NHLStenden-CVDS/TwirreShield/partlist_PCB.xlsx

PARTLIST
R1 | 10K | 0805
R2 | 1K
R3 | 10K
R4 | 10K
R5 | 100
R6 | 100
R7 | 100
R8 | 10k
R9 | 10k
R10 | 10k
R11 | 10k
R12 | 100k
R13 | 15k
R14 | 100k
R15 | 15k
R16 | 100k
R17 | 15k
R18 | 100k
R19 | 15k
R20 | 100
R21 | 100
R22 | 220
Type | Value | Package | Count
Resistor | 100K | 0805 | 4
Resistor | 15K | 0805 | 4
Resistor | 10K | 0805 | 7
Resistor | 1K | 0805 | 1
Resistor | 220 | 0805 | 1
Resistor | 100 | 0805 | 5
LED | RED | 0805 | 2 | http://nl.farnell.com/osram/lsr976/led-0805-red-50mcd-632nm/dp/1226392
LED | GREEN | 0805 | 1 | http://nl.farnell.com/kingbright/kp-2012cgck/led-0805-50mcd-green/dp/2290331
LED | RGB | 5MM | 1 | http://nl.farnell.com/kingbright/l-154a4surkqbdzgw/led-multi-colour-rgb-5mm/dp/2290374
Connector | 6-pin | JST-XH | 1 | http://nl.farnell.com/jst-japan-solderless-terminals/b6b-xh-a-lf-sn/connector-header-tht-2-5mm-6way/dp/1516282
Connector | 5-pin | JST-XH | 3 | http://nl.farnell.com/jst-japan-solderless-terminals/b5b-xh-a-lf-sn/header-tht-vertical-2-5mm-5way/dp/1516281
Connector | 4-pin | JST-XH | 10 | http://nl.farnell.com/jst-japan-solderless-terminals/b4b-xh-a-lf-sn/header-vertical-4way/dp/1516278
Connector | 3-pin | JST-XH | 2 | http://nl.farnell.com/jst-japan-solderless-terminals/b3b-xh-a-lf-sn/header-vertical-3way/dp/1516277
Connector | 2-pin | JST-XH | 1 | http://nl.farnell.com/jst-japan-solderless-terminals/b2b-xh-a-lf-sn/header-vertical-2way/dp/1516276
Plug | 6-pin | JST-XH | 1 | http://nl.farnell.com/jst-japan-solderless-terminals/xhp-6/housing-crimp-receptacle-30-22awg/dp/1516269
Plug | 5-pin | JST-XH | 3 | http://nl.farnell.com/jst-japan-solderless-terminals/xhp-5/housing-crimp-receptacle-30-22awg/dp/1516268
Plug | 4-pin | JST-XH | 10 | http://nl.farnell.com/jst-japan-solderless-terminals/xhp-4/connector-housing-2-5mm-4way/dp/1516266
Plug | 3-pin | JST-XH | 2 | http://nl.farnell.com/jst-japan-solderless-terminals/xhp-3/connector-housing-2-5mm-3way/dp/1516265
Plug | 2-pin | JST-XH | 1 | http://nl.farnell.com/jst-japan-solderless-terminals/xhp-2/connector-housing-2way/dp/1516264
Connector | 2*4 | Boxed header | 1 | http://nl.farnell.com/amphenol/t821108a1s100ceu/header-vertical-2-54mm-8way/dp/2215303
Plug | 2*4 | IDC | 1 | http://nl.farnell.com/fci/71600-008lf/connector-receptacle-idc-2-54mm/dp/2112407
Cap | 560uF | 1010 | 1 | http://nl.farnell.com/panasonic-electronic-components/eeefpe561uap/cap-alu-elec-560uf-25v-smd/dp/1539520
Cap | 47uF | 0605 | 1 | http://nl.farnell.com/panasonic-electronic-components/eee1ca470sp/cap-alu-elec-47uf-16v-smd/dp/9696946
Mosfet | BSS138 | SOT23-3 | 2 | http://nl.farnell.com/nxp/bss138bk/mosfet-n-ch-60v-0-36a-sot23/dp/2053833
PNP Trans | FMMT591A | SOT23-3 | 1 | http://nl.farnell.com/diodes-inc/fmmt591a/transistor-pnp-sot-23/dp/9526722
NPN Trans | FMMT491A | SOT23-3 | 1 | http://nl.farnell.com/diodes-inc/fmmt491a/transistor-npn-sot-23/dp/9526692
