NHLStenden-CVDS/TwirreShield/TwirrePCB/Shield.pdf

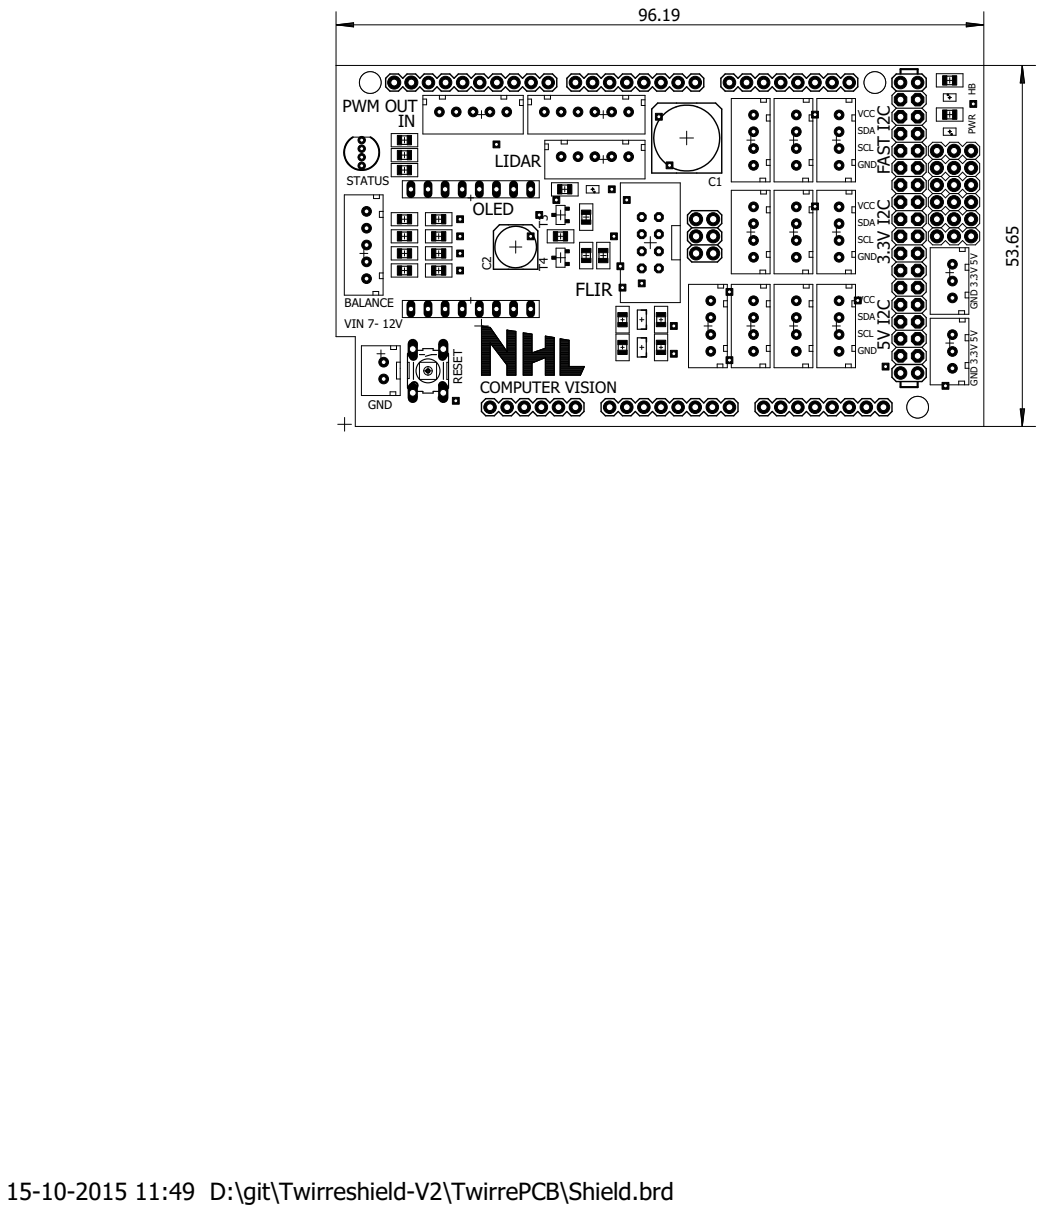
[picture p1: page 1]

GND 3.3V 5V GND 3.3V 5V PWR HB

15-10-2015 11:49 D:\git\Twirreshield-V2\TwirrePCB\Shield.brd
