NHLStenden-CVDS/TwirreShield/TwirrePCB/schematic.pdf

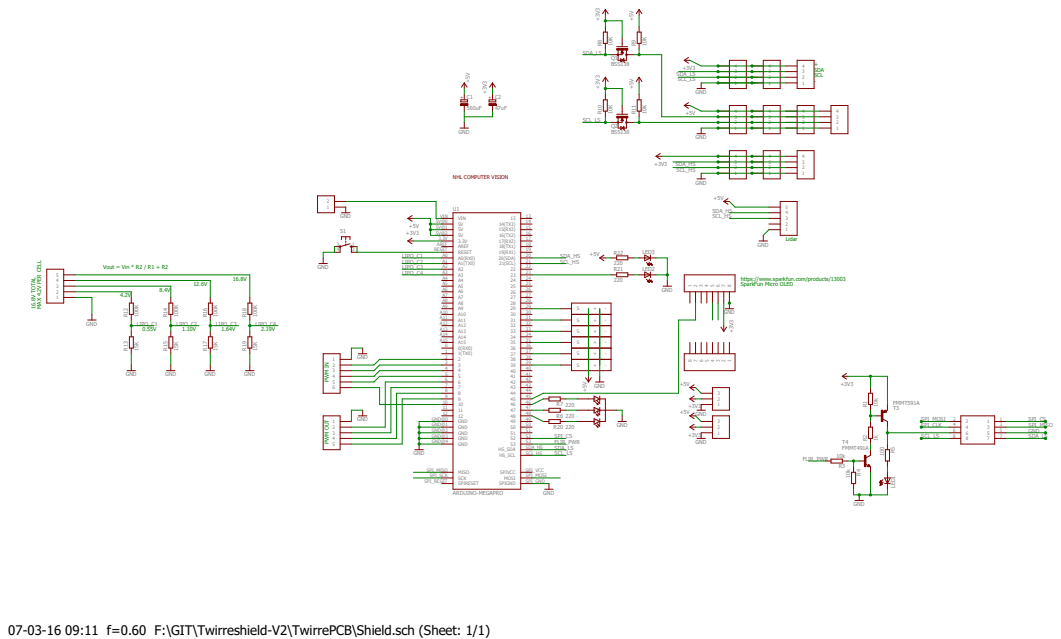
[picture p2: page 1]

https://www.sparkfun.com/products/13003
SparkFun Micro OLED

07-03-16 09:11 f=0.60 F:\GIT\Twirreshield-V2\TwirrePCB\Shield.sch (Sheet: 1/1)
