NHLStenden-CVDS/TwirreShield/TwirrePCB/Shield.brd

## EAGLE design TwirrePCB/Shield.brd (2017-02-13)

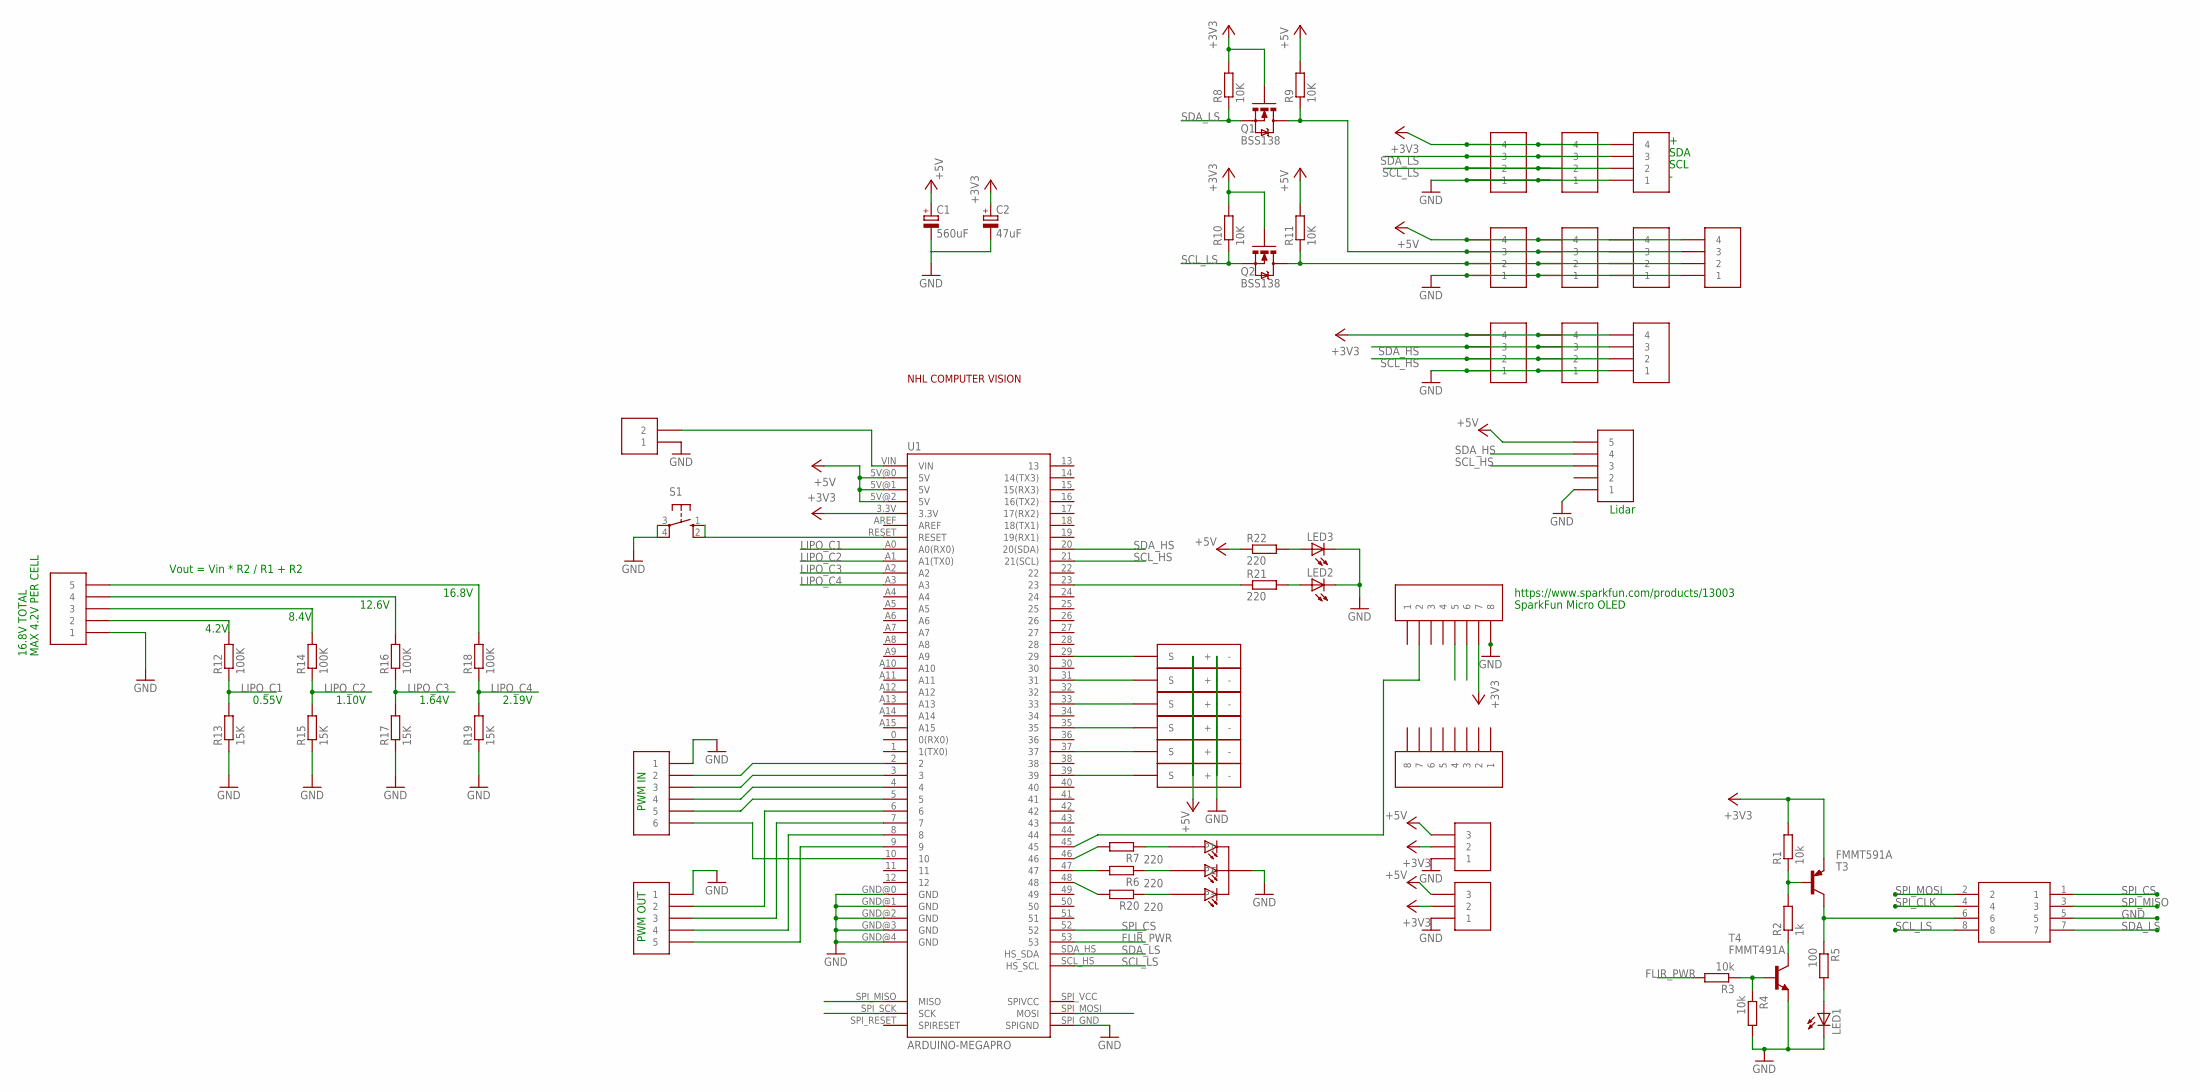
[picture p3: schematic Shield.sch]

Parts:
C1: 560uF; 153CLV-1010
C2: 47uF; 153CLV-0605
LED1, LED2, LED3: LEDSML0805; SML0805
Q1, Q2: BSS138; SOT23-3
R1, R3, R4: 10k; R0805
R2: 1k; R0805
R5: 100; R0805
R6, R7, R20, R21, R22: 220; R0805
R8, R9, R10, R11: 10K; R0805
R12, R14, R16, R18: 100K; R0805
R13, R15, R17, R19: 15K; R0805
S1: 10-XX; B3F-10XX
T3: FMMT591A; SOT23-BCE
T4: FMMT491A; SOT23-BEC
U1: ARDUINO-MEGAPRO; ARDUINO_MEGA-PRO-3.3V
U$1: RGB5MMRGB5MM; RGB5MM
U$2, U$3, U$4, U$5, U$6, U$7, U$8, U$9, U$10, U$11: JST-4
U$12, U$13: LIDAR; JST-5
U$14, U$15: JST-3
U$16: JST-2
U$17: JST-6
U$18: JST-5
U$19, U$20, U$21, U$22, U$23, U$24: SERVOHEADER
U$25: IDC-8WAY
U$26, U$27: OLEDHEADER
U$28: NHLLOGO

Connections:
+3V3: C2.+, Q1.1 (G), Q2.1 (G), R1.2, R8.2, R10.2, T3.E, U1.3.3V, U$2.4, U$3.4, U$4.4, U$8.4, U$9.4, U$10.4, U$14.2, U$15.2, U$26.P$7 (7)
+5V: C1.+, R9.2, R11.2, R22.1, U1.5V@0 (5V), U1.5V@1 (5V), U1.5V@2 (5V), U$5.4, U$6.4, U$7.4, U$11.4, U$12.5, U$14.3, U$15.3, U$19.+, U$20.+, U$21.+, U$22.+, U$23.+, U$24.+
FLIR_PWR: R3.2, U1.53
GND: C1.-, C2.-, LED1.C, LED2.C, LED3.C, R4.2, R13.1, R15.1, R17.1, R19.1, S1.3, S1.4 (P1), T4.E, U1.GND@0 (GND), U1.GND@1 (GND), U1.GND@2 (GND), U1.GND@3 (GND), U1.GND@4 (GND), U1.SPI_GND (SPIGND), U$1.C, U$2.1, U$3.1, U$4.1, U$5.1, U$6.1, U$7.1, U$8.1, U$9.1, U$10.1, U$11.1, U$12.1, U$13.1, U$14.1, U$15.1, U$16.1, U$17.1, U$18.1, U$19.-, U$20.-, U$21.-, U$22.-, U$23.-, U$24.-, U$25.5, U$26.P$8 (8)
LIPO_C1: R12.1, R13.2, U1.A0 (A0(RX0))
LIPO_C2: R14.1, R15.2, U1.A1 (A1(TX0))
LIPO_C3: R16.1, R17.2, U1.A2
LIPO_C4: R18.1, R19.2, U1.A3
unnamed: R1.1, R2.2, T3.B
unnamed: R2.1, T4.C
unnamed: R3.1, R4.1, T4.B
unnamed: LED1.A, R5.2
unnamed: U1.5, U$17.5
unnamed: U1.4, U$17.4
unnamed: R12.2, U$13.2
unnamed: U1.3, U$17.3
unnamed: U1.2, U$17.2
unnamed: R14.2, U$13.3
unnamed: R16.2, U$13.4
unnamed: R18.2, U$13.5
unnamed: U1.10, U$17.6
unnamed: R20.2, U1.48
unnamed: R6.2, U1.47
unnamed: U1.6, U$18.2
unnamed: U1.7, U$18.3
unnamed: U1.8, U$18.4
unnamed: U1.9, U$18.5
unnamed: R7.2, U1.46
unnamed: R20.1, U$1.P3
unnamed: R6.1, U$1.P2
unnamed: R7.1, U$1.P1
unnamed: U1.45, U$26.P$2 (2)
unnamed: U1.35, U$21.S
unnamed: U1.33, U$22.S
unnamed: U1.31, U$23.S
unnamed: U1.39, U$19.S
unnamed: U1.37, U$20.S
unnamed: LED2.A, R21.2
unnamed: R21.1, U1.23
unnamed: LED3.A, R22.2
unnamed: S1.1 (S), S1.2 (S1), U1.RESET
unnamed: U1.VIN, U$16.2
unnamed: U1.29, U$24.S
SCL_HS: U1.21 (21(SCL)), U$8.2, U$9.2, U$10.2, U$12.3
SCL_LS: Q2.2 (S), R10.1, U1.SCL_HS (HS_SCL), U$2.2, U$3.2, U$4.2, U$25.8, U$26.P$5 (5)
SCL_LS_5: Q2.3 (D), R11.1, U$5.2, U$6.2, U$7.2, U$11.2
SDA_HS: U1.20 (20(SDA)), U$8.3, U$9.3, U$10.3, U$12.4
SDA_LS: Q1.2 (S), R8.1, U1.SDA_HS (HS_SDA), U$2.3, U$3.3, U$4.3, U$25.7, U$26.P$6 (6)
SDA_LS_5: Q1.3 (D), R9.1, U$5.3, U$6.3, U$7.3, U$11.3
SPI_CLK: U1.SPI_SCK (SCK), U$25.4
SPI_CS: U1.52, U$25.1
SPI_MISO: U1.SPI_MISO (MISO), U$25.3
SPI_MOSI: U1.SPI_MOSI (MOSI), U$25.2
SPI_VIN: R5.1, T3.C, U$25.6

Notes on the sheet:
SDA
SCL
MAX 4.2V PER CELL
16.8V TOTAL
4.2V
8.4V
12.6V
16.8V
Vout = Vin * R2 / R1 + R2
0.55V
1.10V
1.64V
2.19V
Lidar
PWM IN
PWM OUT
https://www.sparkfun.com/products/13003
SparkFun Micro OLED

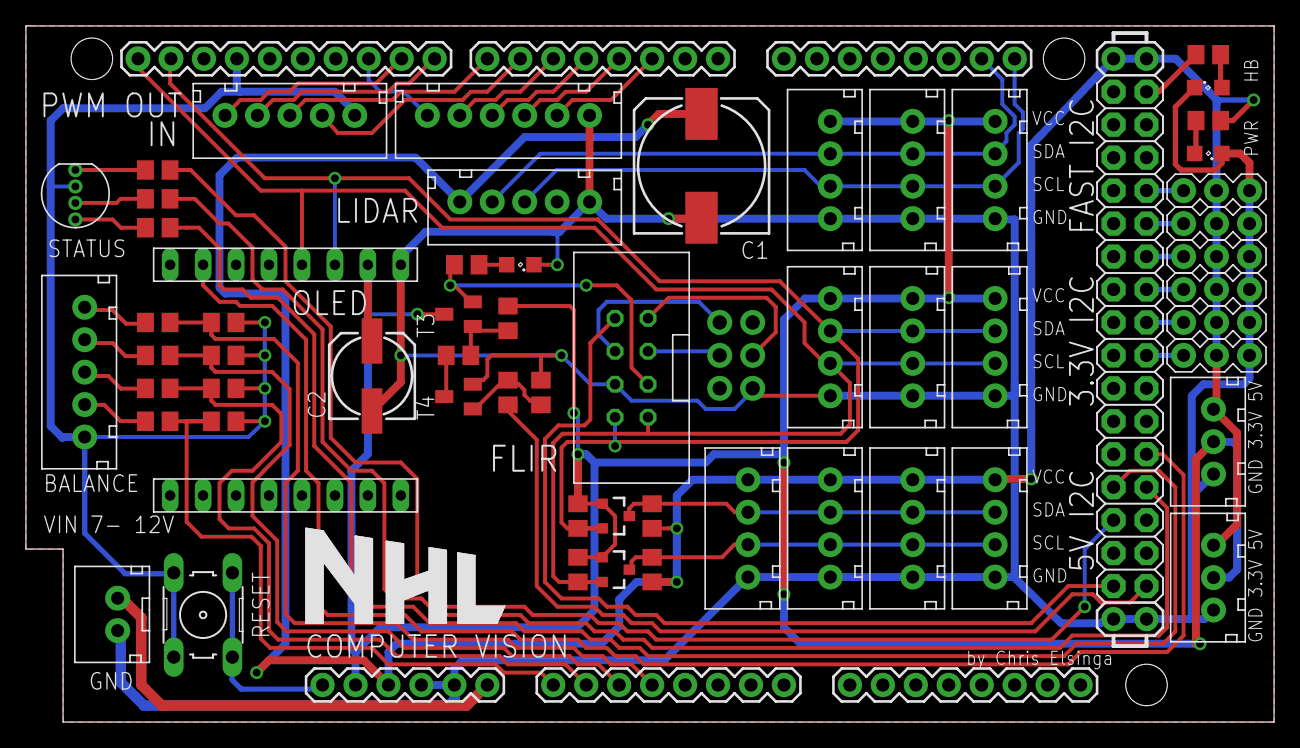
[picture p4: board Shield.brd from above]

Board: 2 copper layers, 96.2 x 53.6 mm, 61 parts (0 on the bottom side), 54 nets.
