NHLStenden-CVDS/TwirreShield/TwirrePDB/TwirrePDB.brd

## EAGLE design TwirrePDB/TwirrePDB.brd (2015-10-06)

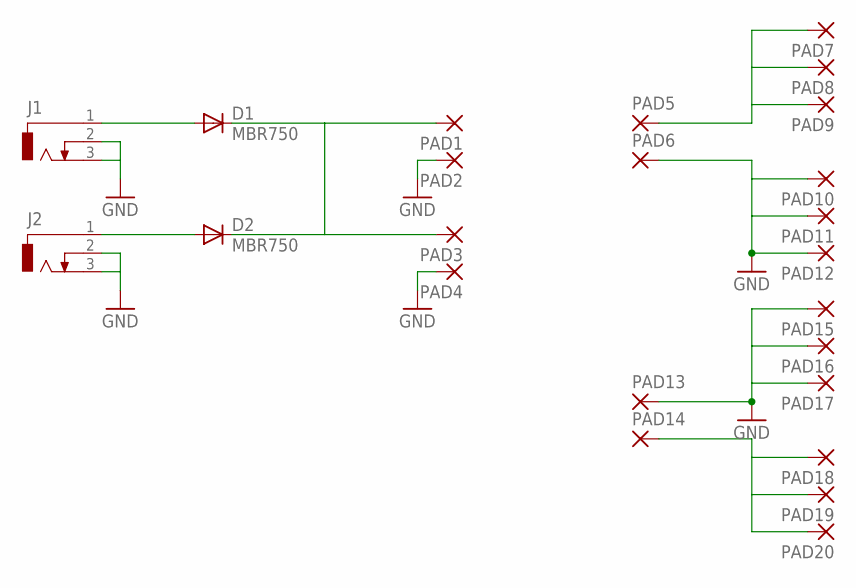
[picture p5: schematic TwirrePDB.sch]

Parts:
D1, D2: MBR750; TO220AC
J1, J2: DCJ0303
PAD1, PAD2, PAD3, PAD4, PAD5, PAD6, PAD7, PAD8, PAD9, PAD10, PAD11, PAD12, PAD13, PAD14, PAD15, PAD16, PAD17, PAD18, PAD19, PAD20: 2,54/0,9

Connections:
5V: PAD14.1, PAD18.1, PAD19.1, PAD20.1
12V: PAD5.1, PAD7.1, PAD8.1, PAD9.1
COMB: D1.C, D2.C, PAD1.1, PAD3.1
GND: J1.2, J1.3, J2.2, J2.3, PAD2.1, PAD4.1, PAD6.1, PAD10.1, PAD11.1, PAD12.1, PAD13.1, PAD15.1, PAD16.1, PAD17.1
unnamed: D2.A, J2.1
unnamed: D1.A, J1.1

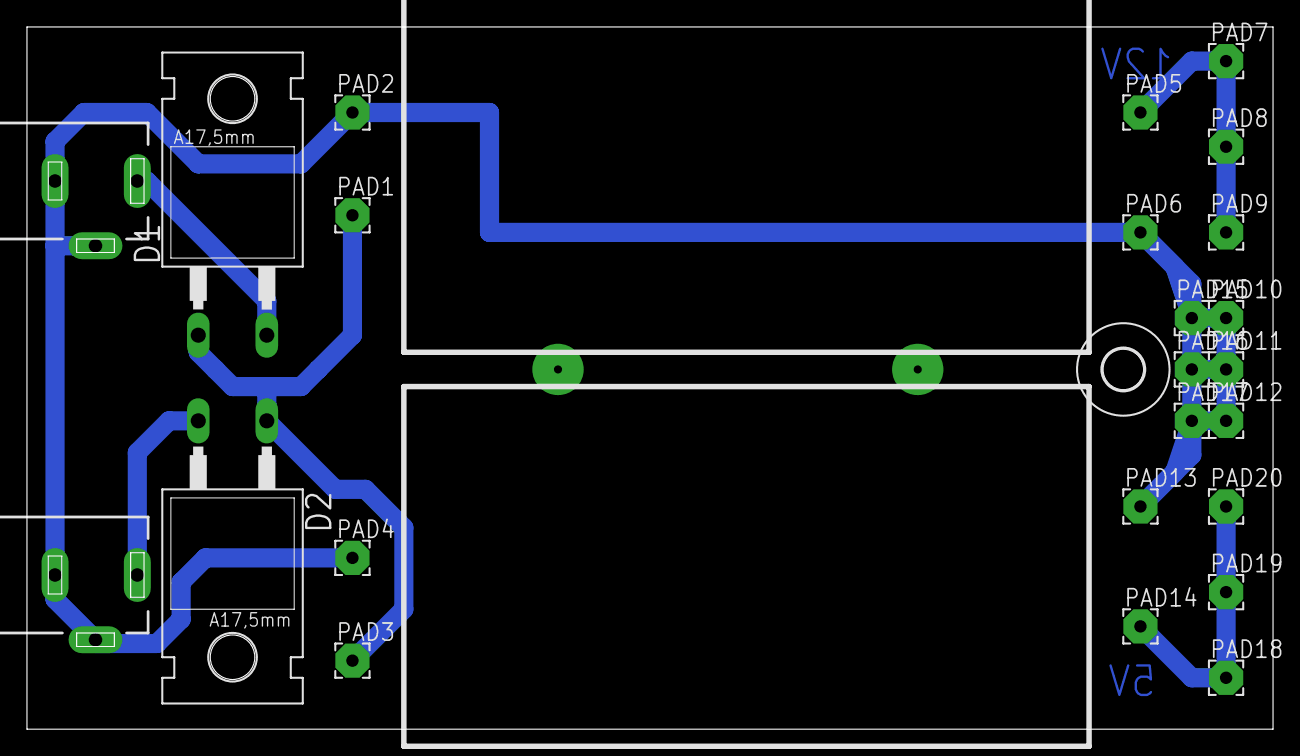
[picture p6: board TwirrePDB.brd from above]

Board: 2 copper layers, 92.4 x 52.1 mm, 25 parts (0 on the bottom side), 6 nets.

Other parts of the board:
U$1: 3,0
