NHLStenden-CVDS/TwirreShield/(commit log)

2015-09-28 Add Arduino Due/Mega shield library
2015-09-28 Add Fast I2C Pins to library
2015-09-28 Basic schematic
    [Shield.brd, Shield.sch]
2015-09-30 Add various components to library
    [Shield.brd, Shield.sch]
2015-09-30 Modify LED part & Add more JST connectors
2015-09-30 Add caps and lots of other stuff
    [Shield.brd, Shield.sch]
2015-09-30 Add IDC 8 way connector
2015-10-01 Move some parts and wires around, finished first revision
    [Shield.brd, Shield.sch]
2015-10-06 Add Power Distribution Board
    [TwirrePDB.brd, TwirrePDB.sch]
2015-10-06 Minor trace modifications
    [Shield.brd, Shield.sch]
2015-10-12 Increase LED Resistor values
    [Shield.brd, Shield.sch]
2015-10-14 Change Transistors for FMMT491A and FMMT591A
    [Shield.brd, Shield.sch]
2015-10-15 Modify OLED and Servo Headers
    [Shield.brd, Shield.sch]
2015-10-15 Add NHL Computer Vision Logo
    [Shield.brd, Shield.sch]
2015-11-06 Increase JST Hole size
    [Shield.brd, Shield.sch]
2017-02-13 Add Credits
    [Shield.brd]
2018-05-25 add partlist
    [partlist_PCB.xlsx]
