NHLStenden-CVDS/TwirreShield/(notices)

Notices in the files:
parts and their libraries:
Arduino-Boards: Licensing: Creative Commons ShareAlike 4.0 International - https://creativecommons.org/licenses/by-sa/4.0
